BrunelleHugo/H25_Pomodoro/CCI_2025_no-1_presentation.pptx

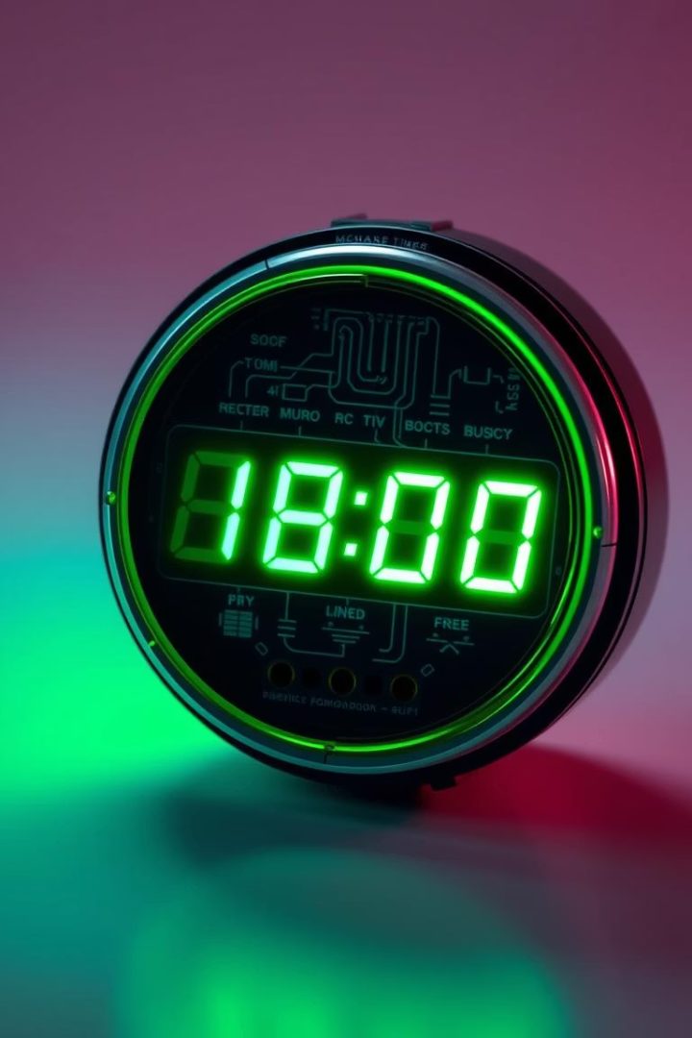
[picture p1: figure]

Pomodedouche (Minuteur Pomodoro)

Pomodedouche améliore la concentration grâce à un minuteur compact et USB-C. Ce projet CCI 2025 intègre un PCB circulaire et un encodeur rotatif.

Équipe 1
Hugo Brunelle et Maxime Gravel

## Slide 2

Présentation du projet Pomodedouche

Composants clés

Caractéristiques techniques

- Alimentation USB-C sécurisée avec protections complètes

- Microcontrôleur ESP32-C3FH4X avec Wi-Fi et Bluetooth

- Écran OLED 0,96" pour affichage net

- Encodeur rotatif DIY à LED infrarouge et phototransistors

- PCB circulaire 2,9 cm, 4 couches pour compacité

- Interface intuitive pour sélectionner durée d’étude

## Slide 3

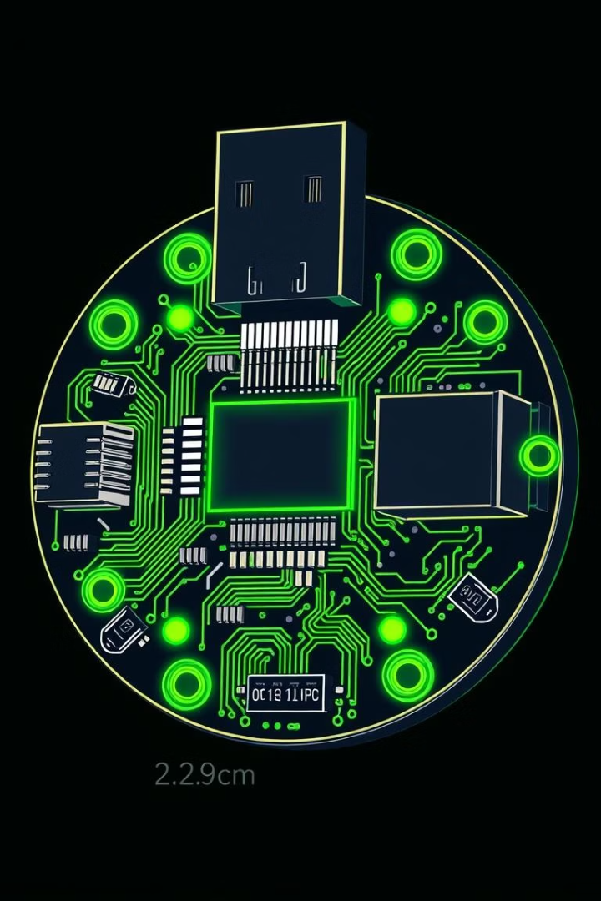
[picture p2: figure]

Respect des contraintes

Coût final inférieur à 30$.

Budget maîtrisé

Intégration USB-C, OLED et encodeur DIY respectée.

Technologie

PCB circulaire conforme : environ 2,9 cm diamètre.

Dimensions

Fichiers Gerber et documentation technique fournis.

Documentation

## Slide 4

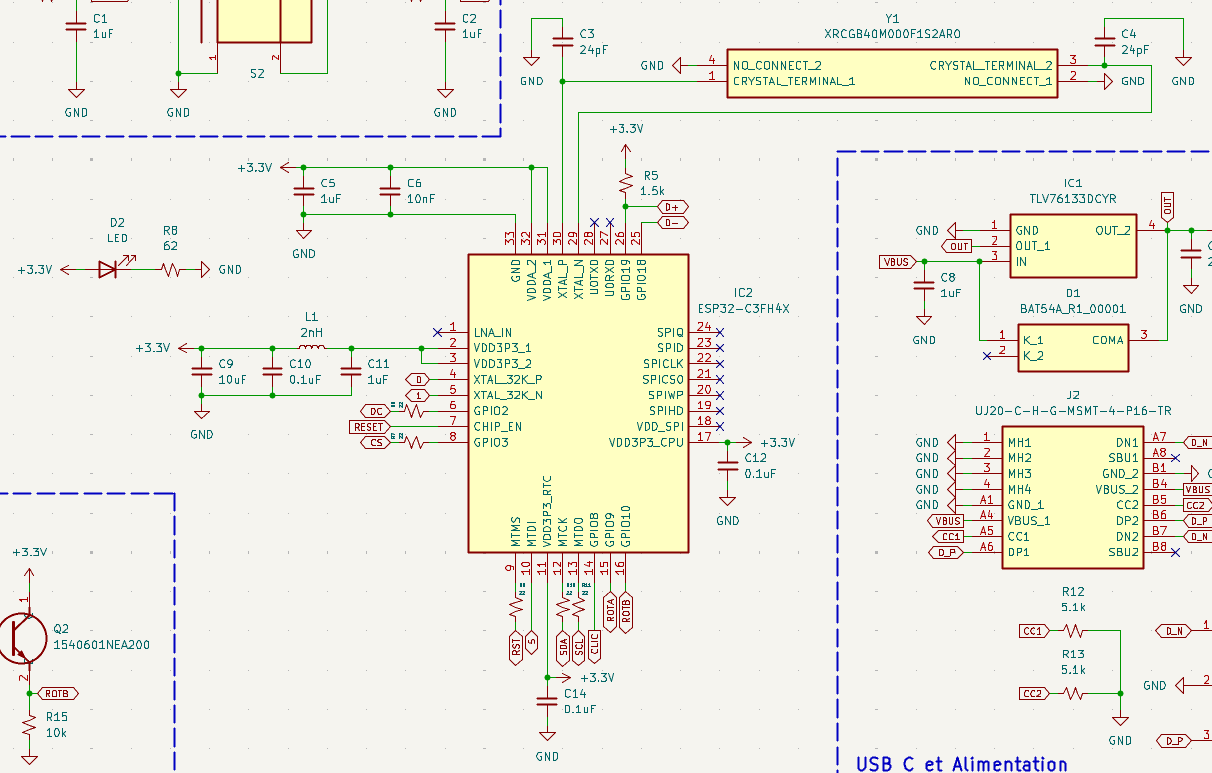
[picture p3: figure]

## Slide 5

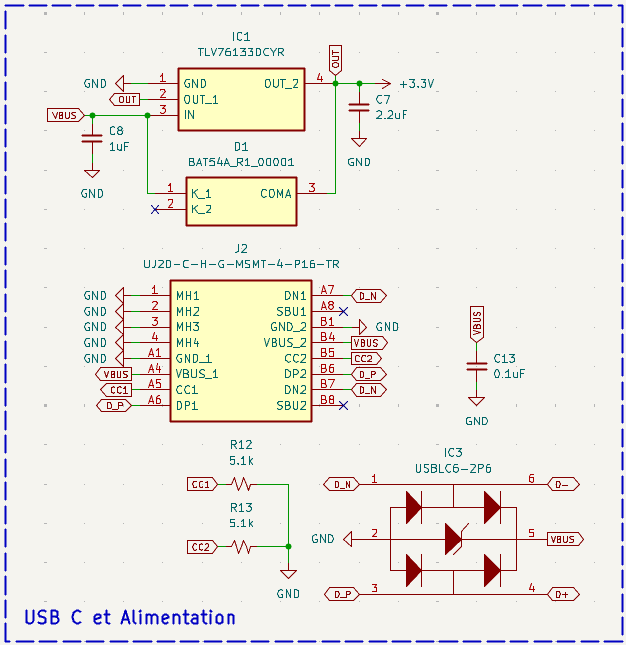
[picture p4: figure]

## Slide 6

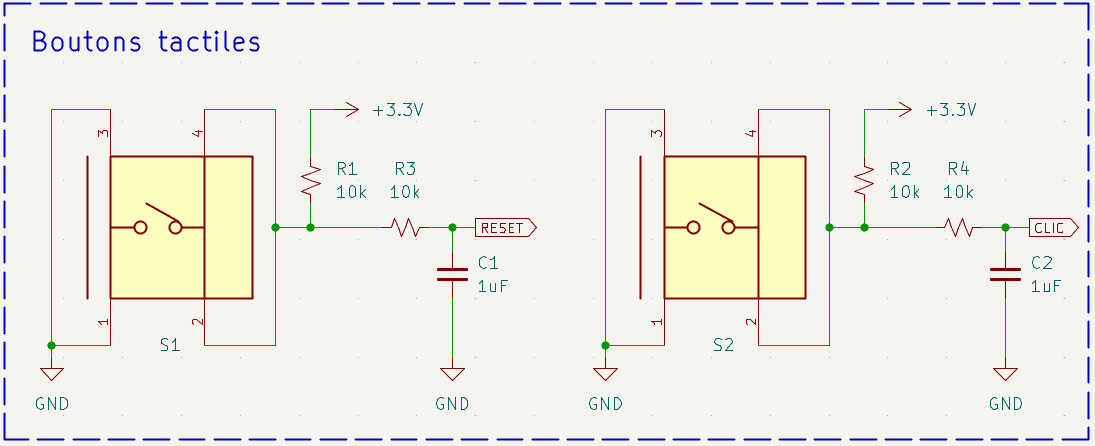
[picture p5: figure]
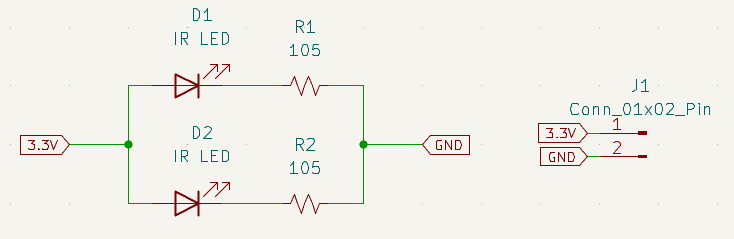
[picture p6: figure]

## Slide 7

Démonstration de l'interface utilisateur

Navigation intuitive

Affichage clair

Réglage facile via encodeur rotatif optoélectronique.

Durée Pomodoro visible sur écran OLED 0,96".

Feedback visuel

Présentation PCB

Démarrage/arrêt avec indication immédiate.

Explication rapide du circuit et fonctionnement optique.

## Slide 8

Période de questions et perspectives

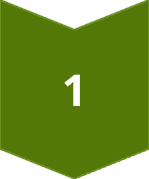
[picture p7: figure]

Questions techniques

Conception, choix composants, USB-C, débogage.

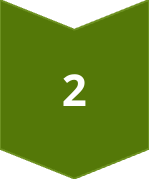
[picture p8: figure]

Pistes d'amélioration

Version batterie et simplification du circuit envisagées.

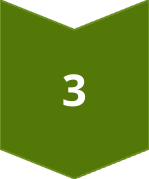
[picture p9: figure]

Discussion ouverte

Échanges constructifs avec juges du CCI 2025.
