BrunelleHugo/H25_Pomodoro/mech/Rotatif.stl

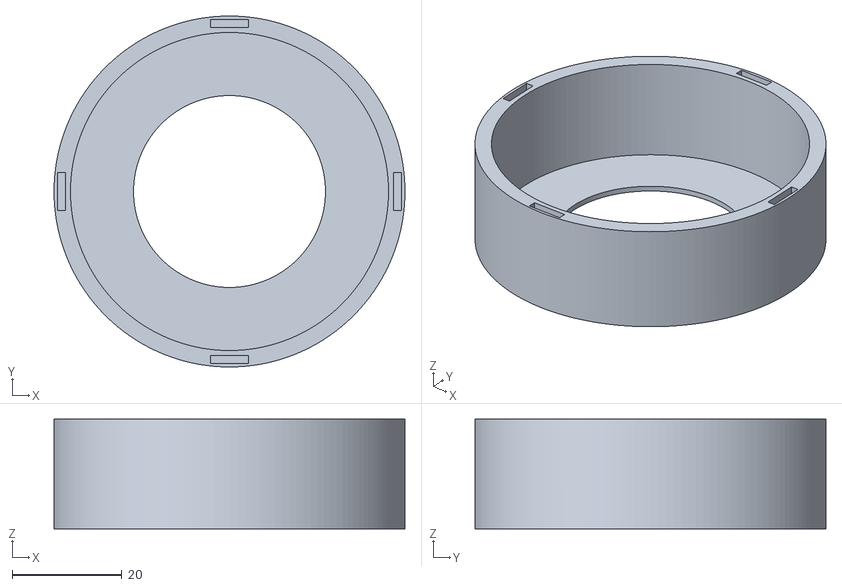
[picture p12: CAD file, 2025-04-27]
mech/Rotatif.stl
64.0 x 64.0 x 20.0
