BrunelleHugo/H25_Pomodoro/mech/Top_Base.stl

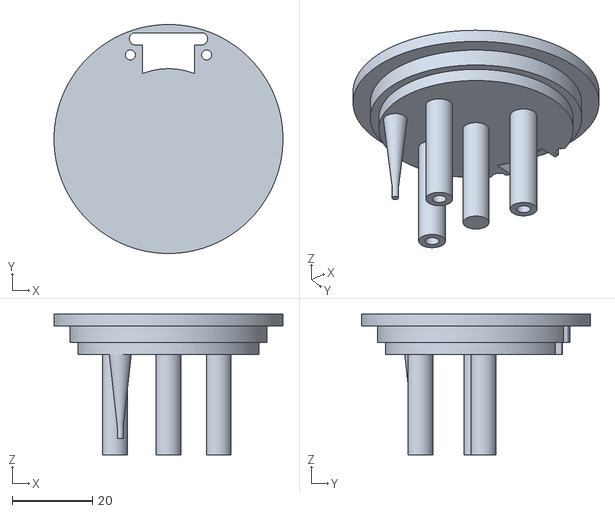
[picture p13: CAD file, 2025-04-27]
mech/Top_Base.stl
57.0 x 57.0 x 35.0
