BrunelleHugo/H25_Pomodoro/mech/Base.stl

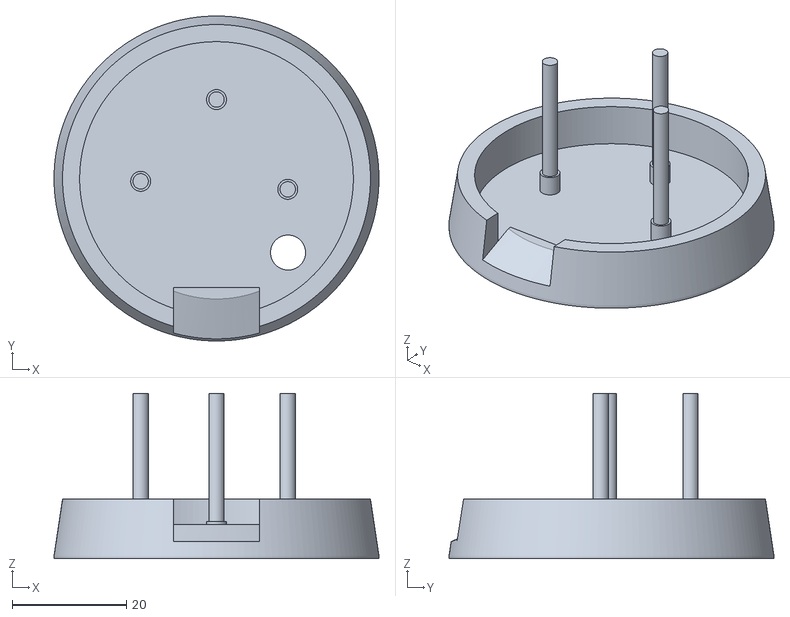
[picture p14: CAD file, 2025-04-27]
mech/Base.stl
57.0 x 57.0 x 29.0
