BrunelleHugo/H25_Pomodoro/mech/Rotatif_Motif.stl

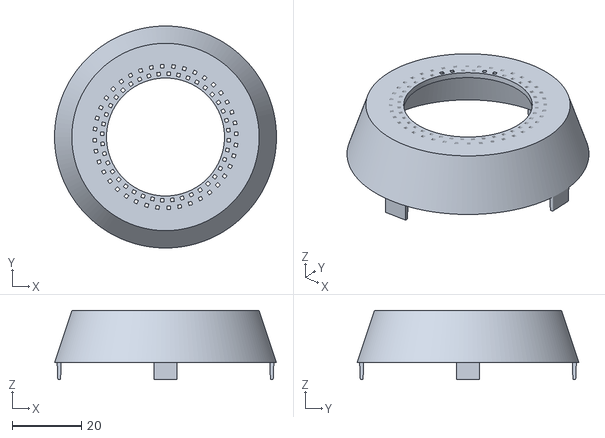
[picture p15: CAD file, 2025-04-27]
mech/Rotatif_Motif.stl
64.0 x 64.0 x 19.9
