BrunelleHugo/H25_Pomodoro/(commit log)

2025-02-24 Ajout du formulaire d'idée
    Expliquer le fonctionnement général de notre système
2025-04-21 Ajout des projets KiCAD
2025-04-21 Ajout des Gerbers
2025-04-21 Ajout du BOM
    [multidesign_pomodedouche.csv]
2025-04-27 Ajout du rapport de C3I en pdf
2025-04-27 Ajout de la présentation
2025-04-27 Ajout des STL
    [Base.stl, Rotatif.stl, Rotatif_Motif.stl, Top_Base.stl]
